satchmo91/BF_8/BF_8_Schematic.png

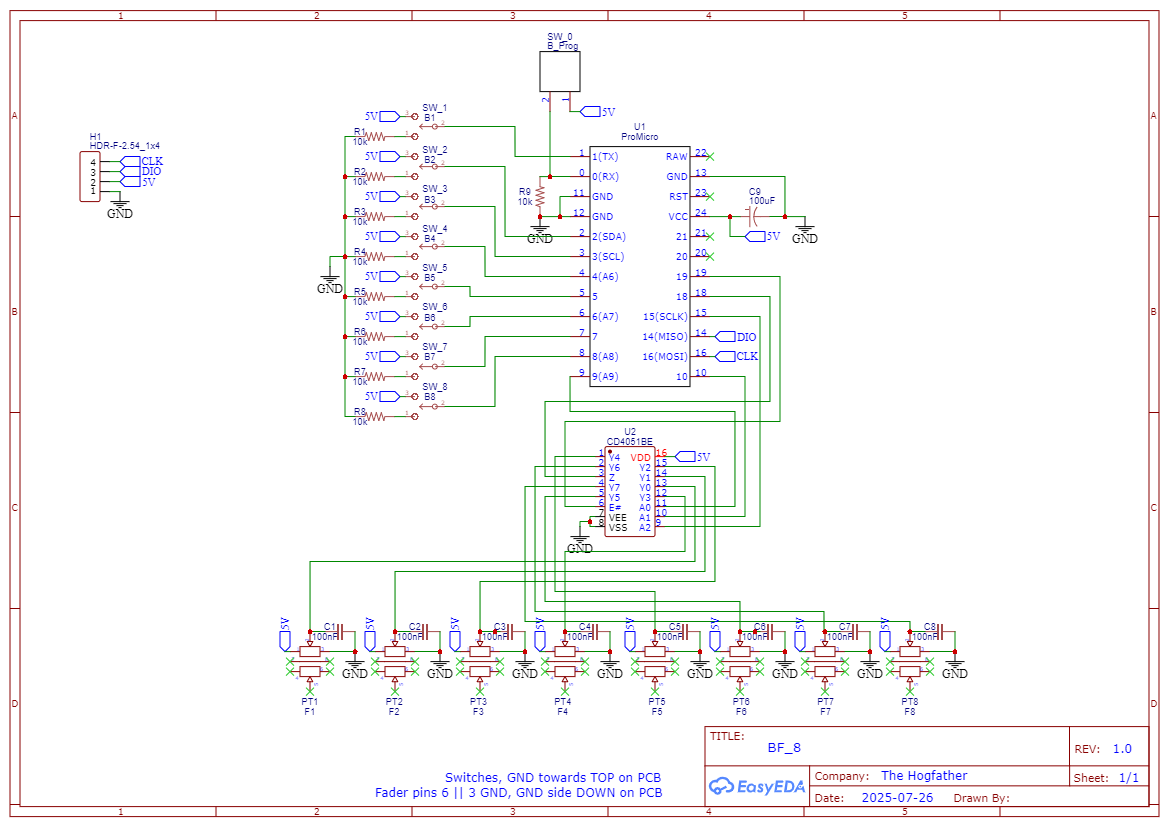
BF_8_Schematic.png
