satchmo91/BF_8/(commit log)

2025-08-25 Added Schematic and BOM
2025-11-11 Complete refactor of the code to make it more maintainable. Also finally fixed the ADC flicker
    [BF_8.ino]
